Cris7z/ElectronicDesignContest2026/NUEDC2026_Car/firmware/h2026_q2/README.md

# 2026 H 题小车单圈灰度循迹固件

本工程只服务当前 C07A/S27F 车辆：板载 D103A/TB6612 驱动底盘，物理左轮为
`PB3/TIMA1_CCP1 + PA16/PA17`，物理右轮为
`PB2/TIMA1_CCP0 + PA14/PA13`。D157B 不参与底盘驱动；左右轮和方向映射
已冻结，换装灰度传感器不改变它们。

主循迹传感器为 CD4051 八路灰度模块，连接为：

```text
PA12 -> AD2       PA27 -> AD1       PB16 -> AD0
PB17 <- OUT (ADC1/A1_4)             5 V / GND 共地
```

PB6/PB7 已从旧 HiWonder UART 释放，但本工程不将其自动分配给 K230。U3 的四线
现在由灰度模块占用，LF04 不可同时接入。

显示使用外接四针 I²C OLED：`GND→GND`、`VCC→3.3 V`、`SCL→PA1`、
`SDA→PA0`。固件使用 I²C0、400 kHz 和默认地址 `0x3C`；与 MPU6050 (`0x68`)
共总线但不冲突。**VCC 不得接 H5 的 5 V。** 原 C07A 四线 OLED
(`PA28/PA31/PB14/PB15`) 已停用。

## 控制链

1. 前台每 5 ms 轮询 CD4051 的 000..111 八个通道；切换地址后默认等待 100 µs，
   丢弃首次 ADC 转换并平均后续四次。扫描超过 1.2 ms 或 ADC 超时会得到无效帧。
2. 白底 1 s、黑线扫掠 5 s 的 BLS 标定生成逐通道白/黑参考；归一化为
   `strength[8]=0..1000`，用 600/400 施密特阈值导出位图。
3. 单个连续线段用连续强度和实测横向坐标计算加权质心；分离多段拒绝，宽线和全黑
   只供起终点 FSM 使用。若 OUT 实物只有两档，算法自然退化为二值质心。
4. 保留既有的变增益低通 PD、顺时针曲率前馈、左右独立
   `kS + kV*v + PI`、比例限幅和编码器里程停车。首轮实车巡迹固定从
   0.20 m/s 开始，确认稳定后才分级提高到 0.30、0.40 m/s。

## 电气与标定门

- 当前装车模块实测白底约 170 ADC、黑线 4095 ADC，表明 OUT 为黑线高电平的
  模拟输出；已按各路标定归一化。仍应在断电改线或更换模块后复测 OUT 的实际电压。
  若最高值超过 (0.9×VDD)，先加 OUT—15 kΩ—PB17、PB17—20 kΩ—GND 分压并
  重新标定；禁止把可能的 5 V 直接送入 PB17。
- 核对 CD4051 实际丝印与供电；5 V 下若地址 VIH 不保证接受 3.3 V，AD0/1/2
  前必须加 74AHCT125。
- 用示波器或 1000 帧对比选择 25/50/100/200 µs 中最短稳定建立时间；没有在
  1.2 ms 内完成的扫描不允许解锁运动。
- BLS 长按 1 s 在白底进入标定；随后 5 s 内手动让黑线扫过所有探头。标定结果写入
  最后 1 KiB 专用 Flash 扇区（`0x1FC00..0x1FFFF`）；链接器已把该扇区从程序区排除。
  写入包含魔数、版本、CRC、提交标志和读回校验，失败则不接受本次标定。2026-07-30
  已保存的逐路白/黑值为 `174/4095, 174/4095, 172/4095, 173/4095,
  171/4095, 172/4095, 171/4095, 171/4095`，坐标为 `-35..+35 mm`，CRC 为
  `0x74D9`。UART0 同时给出原始与归一化八路。
- 当前 `H2026_Q2_COMMISSIONED=1` 仅表示已填入当日实测的按键、传感器、编码器符号
  与 m/count 参数，不表示整圈赛道验收已通过。CH1/R0 已实测为车体左侧。C07A 的
  SW3/BLS 使用 R8=47 kOhm 外部下拉，实测松开 PA18=0、按下 PA18=1，MCU 不启用
  内部上下拉。
- 左右里程比例的地面首测为 `0.700 m / (L=4483, R=4217)`，即左
  `0.0001561454 m/count`、右 `0.0001659948 m/count`，两路非法跳变均为零；轮距
  初值按机械图 `214.2 - 14.5 = 199.7 mm` 填入，仍须用实际转弯再校正有效值。
- 起跑以 BLS 为轮子压在起止线时的里程零点；灰度阵列在前方约 10 cm，故本版不把
  横向启停线当作触发条件。短按一次 BLS 仅在当前灰度帧为有效普通线时直接进入
  循迹；故障后的短按在同一次按键中复位并重新启动。按 6.1416 m 的纯里程门限进入
  0.15 m 的低速收尾并停车。此流程已完成构建与主机回归，尚未完成地面整圈验收。
- OLED 开机首帧会跨越多个 5 ms tick；固件在首帧完成后重新建立 tick 基线，避免把
  启动显示时间误报为 `A03`（应用层 deadline miss）并锁死电机。运行期间真实超期
  仍会立即断能。

## 验证

主机回归：

```powershell
cd D:\X\ElectronicDesignContest2026\ElectronicDesignContest2026\NUEDC2026_Car\sim\h2026_q2
mingw32-make test
```

目标构建：

```powershell
cd D:\X\ElectronicDesignContest2026\ElectronicDesignContest2026\NUEDC2026_Car\firmware\h2026_q2
.\tools\build_ticlang.ps1
```

上车顺序：断电测 OUT 与地址逻辑电平 → 架空逐路扫描和左右轮复核 → 标定编码器/
轮距/停止偏移 → 0.20、0.30、0.40 m/s 分级跑圈。最终必须在不同光照和电量下
连续 20 圈均不丢线、不超期、停车误差不超过 2 cm。

UART0 约 20 Hz 输出 ADC 八路、归一化八路、位图、扫描耗时、状态、轮速、PWM 和
里程；OLED 显示运动锁、位图、扫描统计和故障码。日志不在 ISR 中发送。
