Cris7z/ElectronicDesignContest2026/(commit log)

2026-07-29 Initial hardware architecture, wiring, and firmware sources
2026-07-29 Correct modular controller and line sensor architecture
    [h2026_sim.c]
2026-07-29 Replace line sensor with HiWonder 8CH I2C
    [h2026_sim.c, linefollower_8ch.c, linefollower_8ch.h]
2026-07-30 feat(q2): record C07A gray sensor commissioning
2026-07-30 fix(q2): start directly after OLED boot frame
    [h2026_q2.c, main.c, test_h2026_q2.c]
2026-07-31 docs: add STM32F103 K230 ball-beam bench package
